ToyDr-W/PUYA_orgel_SW_SPI_BTL/Circuit_Schematic/orgel_SW_F002A_8_SPI_BTL.jpg

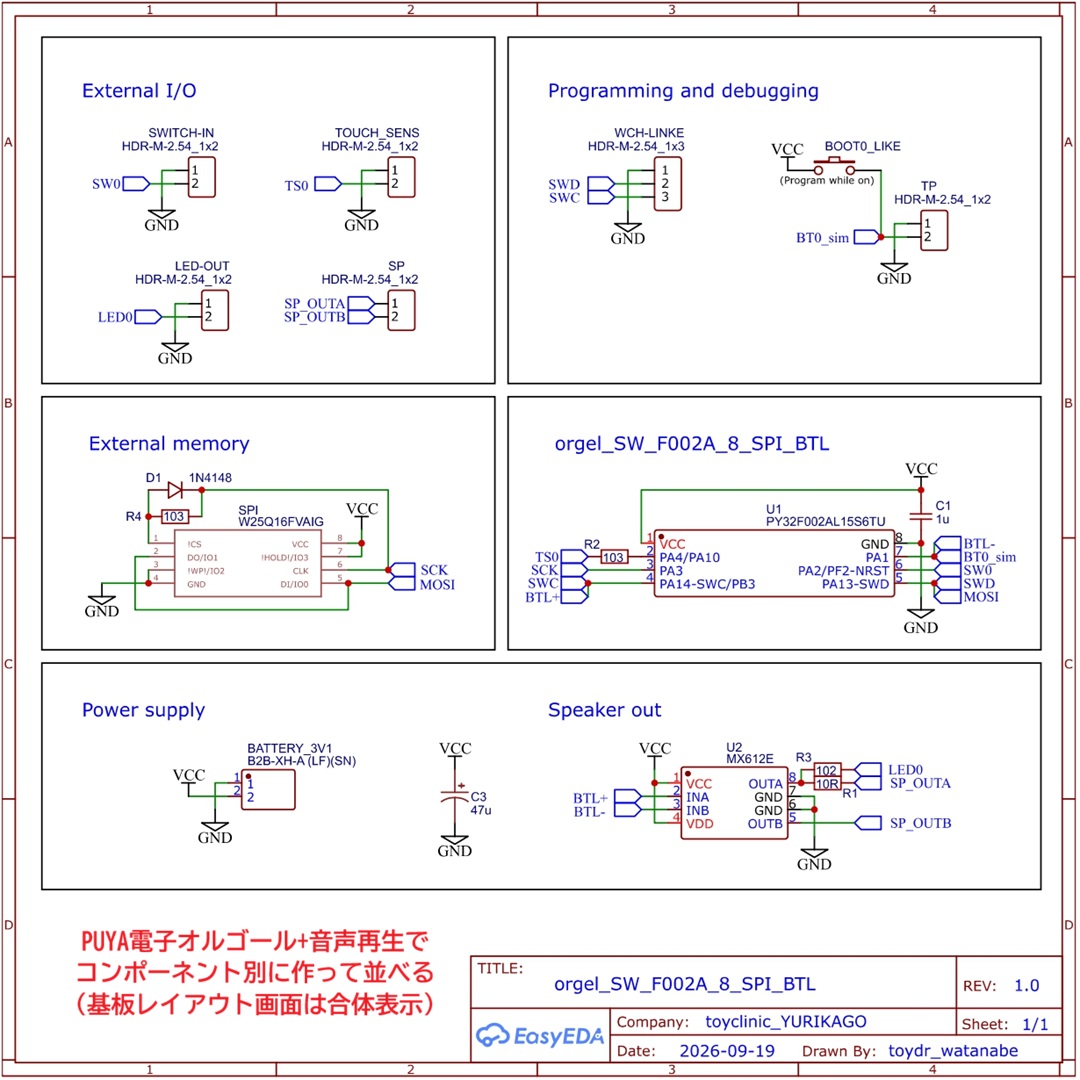
Circuit_Schematic/orgel_SW_F002A_8_SPI_BTL.jpg
