ToyDr-W/PUYA_orgel_SW_SPI_BTL/PCB_Layout/orgel_SW_F002A_8_SPI_BTL.png

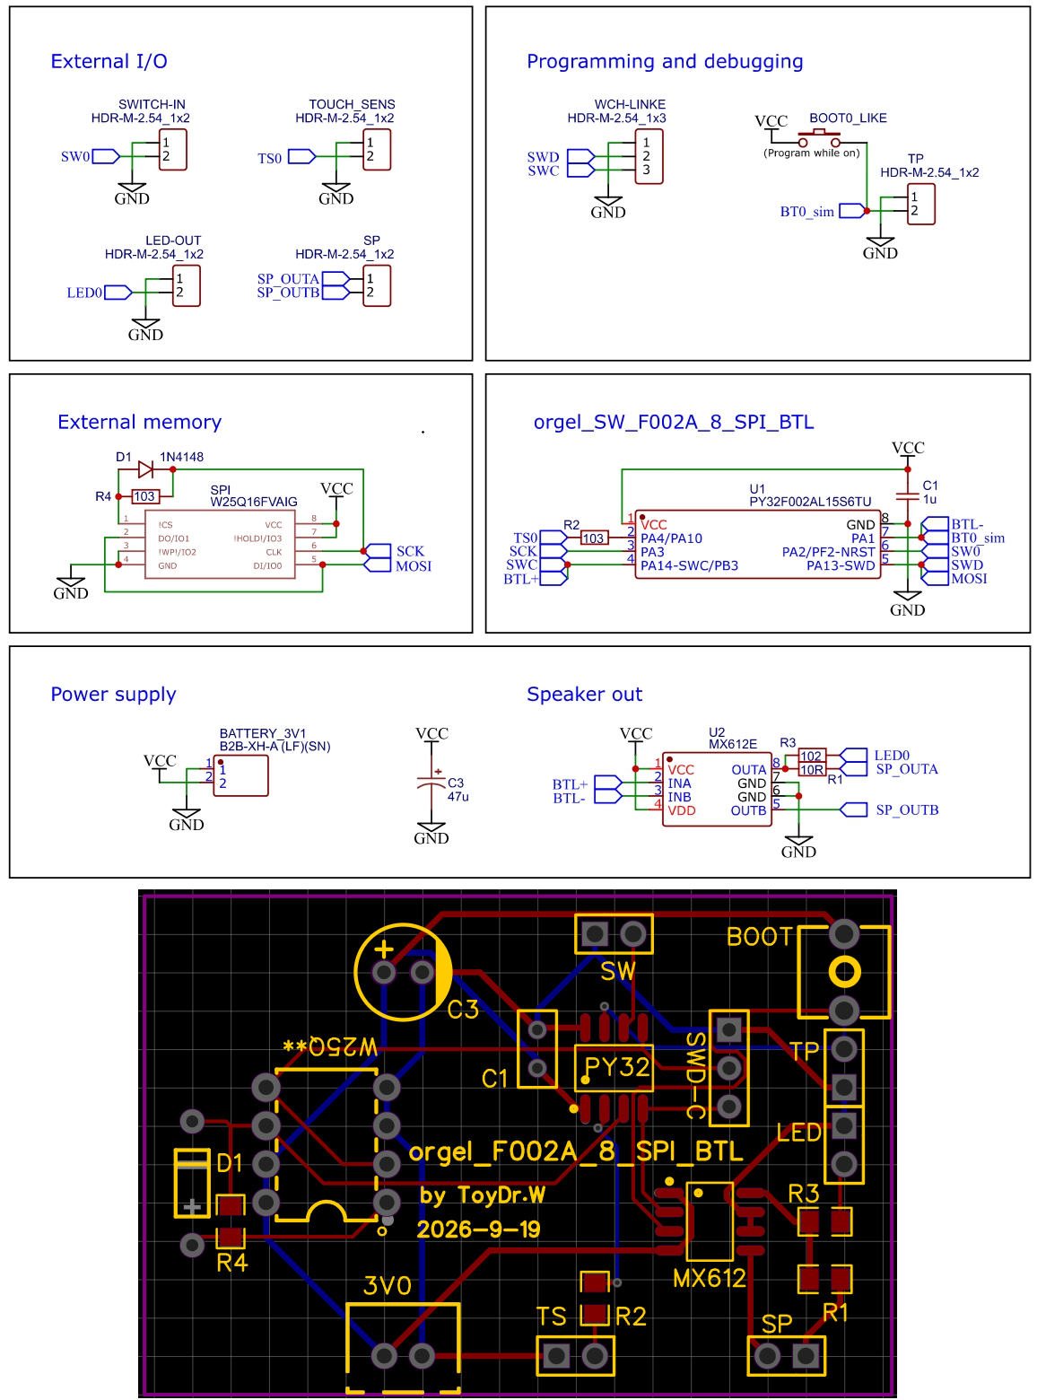
PCB_Layout/orgel_SW_F002A_8_SPI_BTL.png
