ToyDr-W/PUYA_orgel_SW_SPI_BTL/PCB_Layout/orgel_SW_F002A_SPI_BTL_Rev1 (2).png

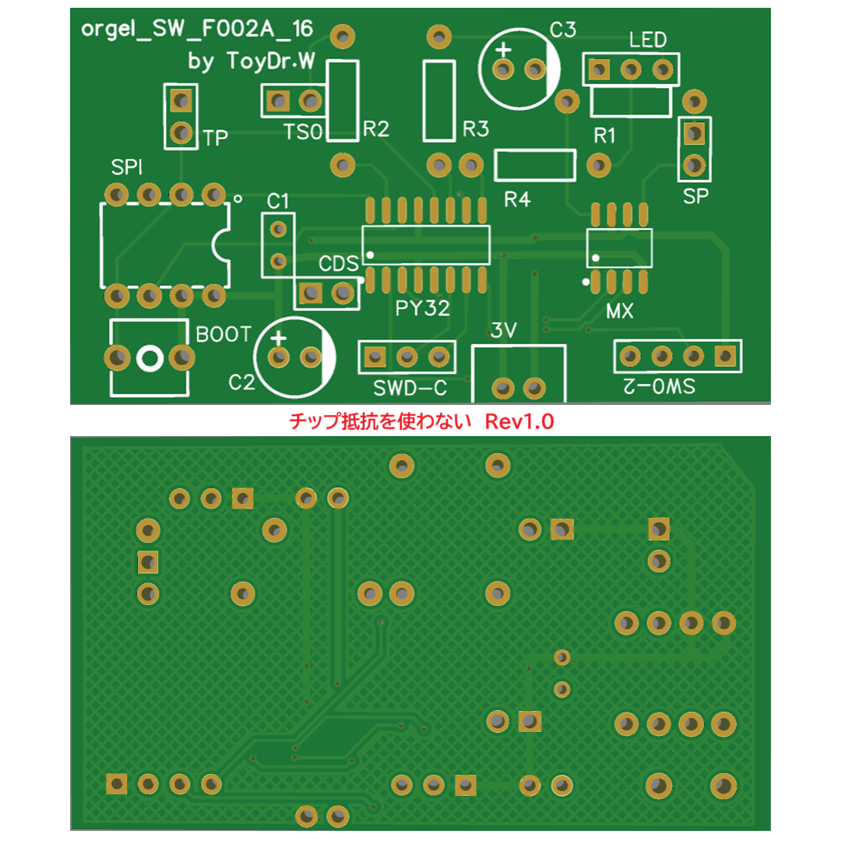
PCB_Layout/orgel_SW_F002A_SPI_BTL_Rev1 (2).png
