ToyDr-W/PUYA_orgel_SW_SPI_BTL/orgel1_4_260929/tool_voice/wav2txt/Release/BuildLog.htm

ビルド ログ

| | リビルド 開始: プロジェクト: wav2txt、構成: Release|Win32

コマンド ライン

一時ファイル "d:\ooizumi\PIC\orgel5_7\tool\wav2txt\Release\RSP00000158687376.rsp" を作成しています。内容 :
[
/O2 /Oi /GL /D "WIN32" /D "NDEBUG" /D "_CONSOLE" /D "_UNICODE" /D "UNICODE" /FD /EHsc /MD /Gy /Fo"Release\\" /Fd"Release\vc90.pdb" /W3 /c /Zi /TP .\wav2txt.cpp
]
コマンド ライン "cl.exe @d:\ooizumi\PIC\orgel5_7\tool\wav2txt\Release\RSP00000158687376.rsp /nologo /errorReport:prompt" を作成しています。
一時ファイル "d:\ooizumi\PIC\orgel5_7\tool\wav2txt\Release\RSP00000258687376.rsp" を作成しています。内容 :
[
/OUT:"D:\ooizumi\PIC\orgel5_7\tool\wav2txt\Release\wav2txt.exe" /INCREMENTAL:NO /MANIFEST /MANIFESTFILE:"Release\wav2txt.exe.intermediate.manifest" /MANIFESTUAC:"level='asInvoker' uiAccess='false'" /DEBUG /PDB:"D:\ooizumi\PIC\orgel5_7\tool\wav2txt\Release\wav2txt.pdb" /SUBSYSTEM:CONSOLE /OPT:REF /OPT:ICF /LTCG /DYNAMICBASE /NXCOMPAT /MACHINE:X86 kernel32.lib user32.lib gdi32.lib winspool.lib comdlg32.lib advapi32.lib shell32.lib ole32.lib oleaut32.lib uuid.lib odbc32.lib odbccp32.lib

".\Release\wav2txt.obj"
]
コマンド ライン "link.exe @d:\ooizumi\PIC\orgel5_7\tool\wav2txt\Release\RSP00000258687376.rsp /NOLOGO /ERRORREPORT:PROMPT" を作成しています。
一時ファイル "d:\ooizumi\PIC\orgel5_7\tool\wav2txt\Release\RSP00000358687376.rsp" を作成しています。内容 :
[
/outputresource:".\Release\wav2txt.exe;#1" /manifest

.\Release\wav2txt.exe.intermediate.manifest
]
コマンド ライン "mt.exe @d:\ooizumi\PIC\orgel5_7\tool\wav2txt\Release\RSP00000358687376.rsp /nologo" を作成しています。
一時ファイル "d:\ooizumi\PIC\orgel5_7\tool\wav2txt\Release\BAT00000458687376.bat" を作成しています。内容 :
[
@echo マニフェスト リソースの最終更新日時: %TIME% (%DATE%) > .\Release\mt.dep
]
コマンド ライン "d:\ooizumi\PIC\orgel5_7\tool\wav2txt\Release\BAT00000458687376.bat" を作成しています。

出力ウィンドウ

コンパイルしています...
wav2txt.cpp
.\wav2txt.cpp(223) : warning C4996: 'fopen': This function or variable may be unsafe. Consider using fopen_s instead. To disable deprecation, use _CRT_SECURE_NO_WARNINGS. See online help for details.
C:\Program Files (x86)\Microsoft Visual Studio 9.0\VC\include\stdio.h(237) : 'fopen' の宣言を確認してください。
.\wav2txt.cpp(228) : warning C4996: 'fileno': The POSIX name for this item is deprecated. Instead, use the ISO C++ conformant name: _fileno. See online help for details.
C:\Program Files (x86)\Microsoft Visual Studio 9.0\VC\include\stdio.h(722) : 'fileno' の宣言を確認してください。
.\wav2txt.cpp(240) : warning C4996: 'fopen': This function or variable may be unsafe. Consider using fopen_s instead. To disable deprecation, use _CRT_SECURE_NO_WARNINGS. See online help for details.
C:\Program Files (x86)\Microsoft Visual Studio 9.0\VC\include\stdio.h(237) : 'fopen' の宣言を確認してください。
リンクしています...
コード生成しています。
コード生成が終了しました。
マニフェストを埋め込んでいます...

結果

| | ビルドログは "file://d:\ooizumi\PIC\orgel5_7\tool\wav2txt\Release\BuildLog.htm" に保存されました。 wav2txt - エラー 0、警告 3
