ToyDr-W/PUYA_orgel_SW_SPI_BTL/orgel1_4_261018/tool_voice/txt2asm/Release/BuildLog.htm

ビルド ログ

| | リビルド 開始: プロジェクト: txt2asm、構成: Release|Win32

コマンド ライン

一時ファイル "c:\ooizumis\WCH\orgel1_4-NNN\tool_voice\txt2asm\Release\RSP00000527847000.rsp" を作成しています。内容 :
[
/O2 /Oi /GL /D "WIN32" /D "NDEBUG" /D "_CONSOLE" /D "_UNICODE" /D "UNICODE" /FD /EHsc /MD /Gy /Fo"Release\\" /Fd"Release\vc90.pdb" /W3 /c /Zi /TP ".\txt2asm.cpp"
]
コマンド ライン "cl.exe @"c:\ooizumis\WCH\orgel1_4-NNN\tool_voice\txt2asm\Release\RSP00000527847000.rsp" /nologo /errorReport:prompt" を作成しています。
一時ファイル "c:\ooizumis\WCH\orgel1_4-NNN\tool_voice\txt2asm\Release\RSP00000627847000.rsp" を作成しています。内容 :
[
/OUT:"C:\ooizumis\WCH\orgel1_4-NNN\tool_voice\txt2asm\Release\txt2asm.exe" /INCREMENTAL:NO /MANIFEST /MANIFESTFILE:"Release\txt2asm.exe.intermediate.manifest" /MANIFESTUAC:"level='asInvoker' uiAccess='false'" /DEBUG /PDB:"C:\ooizumis\WCH\orgel1_4-NNN\tool_voice\txt2asm\Release\txt2asm.pdb" /SUBSYSTEM:CONSOLE /OPT:REF /OPT:ICF /LTCG /DYNAMICBASE /NXCOMPAT /MACHINE:X86 kernel32.lib user32.lib gdi32.lib winspool.lib comdlg32.lib advapi32.lib shell32.lib ole32.lib oleaut32.lib uuid.lib odbc32.lib odbccp32.lib

".\Release\txt2asm.obj"
]
コマンド ライン "link.exe @"c:\ooizumis\WCH\orgel1_4-NNN\tool_voice\txt2asm\Release\RSP00000627847000.rsp" /NOLOGO /ERRORREPORT:PROMPT" を作成しています。
一時ファイル "c:\ooizumis\WCH\orgel1_4-NNN\tool_voice\txt2asm\Release\RSP00000727847000.rsp" を作成しています。内容 :
[
/outputresource:".\Release\txt2asm.exe;#1" /manifest

".\Release\txt2asm.exe.intermediate.manifest"
]
コマンド ライン "mt.exe @"c:\ooizumis\WCH\orgel1_4-NNN\tool_voice\txt2asm\Release\RSP00000727847000.rsp" /nologo" を作成しています。
一時ファイル "c:\ooizumis\WCH\orgel1_4-NNN\tool_voice\txt2asm\Release\BAT00000827847000.bat" を作成しています。内容 :
[
@echo マニフェスト リソースの最終更新日時: %TIME% (%DATE%) > ".\Release\mt.dep"
]
コマンド ライン """c:\ooizumis\WCH\orgel1_4-NNN\tool_voice\txt2asm\Release\BAT00000827847000.bat""" を作成しています。

出力ウィンドウ

コンパイルしています...
txt2asm.cpp
.\txt2asm.cpp(240) : warning C4996: 'fopen': This function or variable may be unsafe. Consider using fopen_s instead. To disable deprecation, use _CRT_SECURE_NO_WARNINGS. See online help for details.
C:\Program Files (x86)\Microsoft Visual Studio 9.0\VC\include\stdio.h(237) : 'fopen' の宣言を確認してください。
.\txt2asm.cpp(298) : warning C4244: '=' : 'unsigned long' から 'unsigned short' への変換です。データが失われる可能性があります。
.\txt2asm.cpp(426) : warning C4996: 'fopen': This function or variable may be unsafe. Consider using fopen_s instead. To disable deprecation, use _CRT_SECURE_NO_WARNINGS. See online help for details.
C:\Program Files (x86)\Microsoft Visual Studio 9.0\VC\include\stdio.h(237) : 'fopen' の宣言を確認してください。
リンクしています...
コード生成しています。
コード生成が終了しました。
マニフェストを埋め込んでいます...

結果

| | ビルドログは "file://c:\ooizumis\WCH\orgel1_4-NNN\tool_voice\txt2asm\Release\BuildLog.htm" に保存されました。 txt2asm - エラー 0、警告 3
