ToyDr-W/PUYA_orgel_SW_SPI_BTL/orgel1_4_261018/tool_voice/wav2hex/Release/BuildLog.htm

ビルド ログ

| | リビルド 開始: プロジェクト: wav2hex、構成: Release|Win32

コマンド ライン

一時ファイル "c:\ooizumis\WCH\orgel1_4-NNN\tool_voice\wav2hex\Release\RSP00001127449432.rsp" を作成しています。内容 :
[
/GL /D "WIN32" /D "NDEBUG" /D "_UNICODE" /D "UNICODE" /FD /EHa /MD /Fo"Release\\" /Fd"Release\vc90.pdb" /W3 /c /Zi /clr /TP ".\wav2hex.cpp"
]
コマンド ライン "cl.exe @"c:\ooizumis\WCH\orgel1_4-NNN\tool_voice\wav2hex\Release\RSP00001127449432.rsp" /nologo /errorReport:prompt" を作成しています。
一時ファイル "c:\ooizumis\WCH\orgel1_4-NNN\tool_voice\wav2hex\Release\RSP00001227449432.rsp" を作成しています。内容 :
[
/OUT:"C:\ooizumis\WCH\orgel1_4-NNN\tool_voice\wav2hex\Release\wav2hex.exe" /INCREMENTAL:NO /MANIFEST /MANIFESTFILE:"Release\wav2hex.exe.intermediate.manifest" /MANIFESTUAC:"level='asInvoker' uiAccess='false'" /DEBUG /PDB:"C:\ooizumis\WCH\orgel1_4-NNN\tool_voice\wav2hex\Release\wav2hex.pdb" /LTCG /DYNAMICBASE /FIXED:No /NXCOMPAT /MACHINE:X86 ".\Release\wav2hex.obj"
]
コマンド ライン "link.exe @"c:\ooizumis\WCH\orgel1_4-NNN\tool_voice\wav2hex\Release\RSP00001227449432.rsp" /NOLOGO /ERRORREPORT:PROMPT" を作成しています。
一時ファイル "c:\ooizumis\WCH\orgel1_4-NNN\tool_voice\wav2hex\Release\RSP00001327449432.rsp" を作成しています。内容 :
[
/outputresource:".\Release\wav2hex.exe;#1" /manifest

".\Release\wav2hex.exe.intermediate.manifest"
]
コマンド ライン "mt.exe @"c:\ooizumis\WCH\orgel1_4-NNN\tool_voice\wav2hex\Release\RSP00001327449432.rsp" /nologo" を作成しています。
一時ファイル "c:\ooizumis\WCH\orgel1_4-NNN\tool_voice\wav2hex\Release\BAT00001427449432.bat" を作成しています。内容 :
[
@echo マニフェスト リソースの最終更新日時: %TIME% (%DATE%) > ".\Release\mt.dep"
]
コマンド ライン """c:\ooizumis\WCH\orgel1_4-NNN\tool_voice\wav2hex\Release\BAT00001427449432.bat""" を作成しています。

出力ウィンドウ

コンパイルしています...
wav2hex.cpp
.\wav2hex.cpp(533) : warning C4244: '=' : 'unsigned short' から 'unsigned char' への変換です。データが失われる可能性があります。
.\wav2hex.cpp(534) : warning C4244: '=' : 'unsigned short' から 'unsigned char' への変換です。データが失われる可能性があります。
.\wav2hex.cpp(535) : warning C4244: '=' : 'unsigned short' から 'unsigned char' への変換です。データが失われる可能性があります。
.\wav2hex.cpp(687) : warning C4996: 'fopen': This function or variable may be unsafe. Consider using fopen_s instead. To disable deprecation, use _CRT_SECURE_NO_WARNINGS. See online help for details.
C:\Program Files (x86)\Microsoft Visual Studio 9.0\VC\include\stdio.h(237) : 'fopen' の宣言を確認してください。
.\wav2hex.cpp(693) : warning C4996: 'fopen': This function or variable may be unsafe. Consider using fopen_s instead. To disable deprecation, use _CRT_SECURE_NO_WARNINGS. See online help for details.
C:\Program Files (x86)\Microsoft Visual Studio 9.0\VC\include\stdio.h(237) : 'fopen' の宣言を確認してください。
.\wav2hex.cpp(699) : warning C4996: 'fopen': This function or variable may be unsafe. Consider using fopen_s instead. To disable deprecation, use _CRT_SECURE_NO_WARNINGS. See online help for details.
C:\Program Files (x86)\Microsoft Visual Studio 9.0\VC\include\stdio.h(237) : 'fopen' の宣言を確認してください。
.\wav2hex.cpp(736) : warning C4996: 'fopen': This function or variable may be unsafe. Consider using fopen_s instead. To disable deprecation, use _CRT_SECURE_NO_WARNINGS. See online help for details.
C:\Program Files (x86)\Microsoft Visual Studio 9.0\VC\include\stdio.h(237) : 'fopen' の宣言を確認してください。
リンクしています...
コード生成しています。
コード生成が終了しました。
マニフェストを埋め込んでいます...

結果

| | ビルドログは "file://c:\ooizumis\WCH\orgel1_4-NNN\tool_voice\wav2hex\Release\BuildLog.htm" に保存されました。 wav2hex - エラー 0、警告 7
