ToyDr-W/PUYA_orgel_SW_SPI_BTL/Circuit_Schematic/orgel_SW_F002A_16_SPI_BTL.pdf

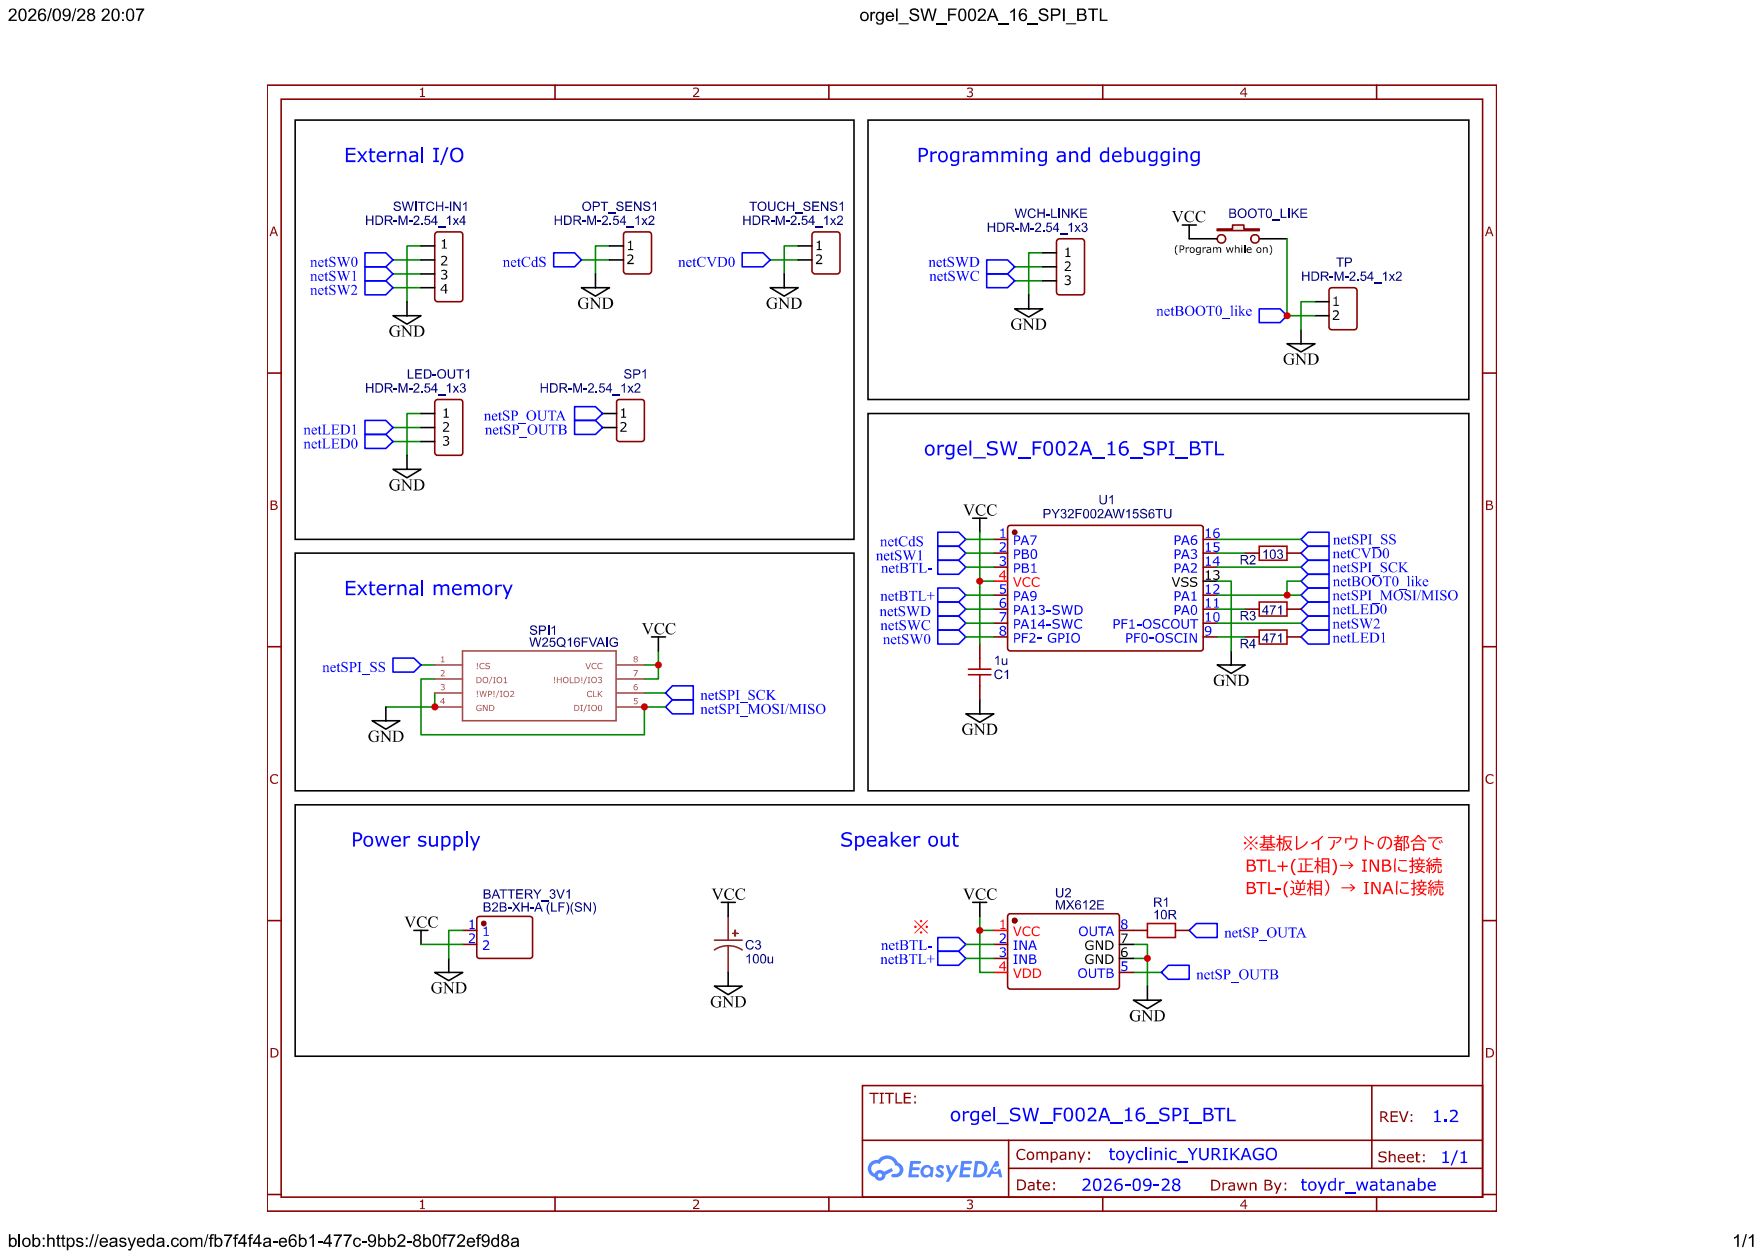
[picture p9: page 1]
