ToyDr-W/PUYA_orgel_SW_SPI_BTL/orgel1_4_260929/voice_AKA.c

static const unsigned char voice_AKA[]={
	125,
	133,
	143,
	139,
	113,
	107,
	122,
	145,
	135,
	119,
	117,
	136,
	137,
	128,
	126,
	137,
	133,
	119,
	118,
	128,
	136,
	131,
	127,
	126,
	125,
	126,
	128,
	130,
	129,
	126,
	128,
	130,
	130,
	130,
	128,
	125,
	118,
	119,
	130,
	137,
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
	};
