ToyDr-W/PUYA_orgel_SW_SPI_BTL/orgel1_4_260929/voice_AO.c

static const unsigned char voice_AO[]={
	127,
	127,
	127,
	127,
	127,
	127,
	127,
	127,
	127,
	127,
	127,
	127,
	127,
	127,
	127,
	127,
	127,
	127,
	127,
	128,
	128,
	128,
	127,
	127,
	127,
	126,
	126,
	125,
	140,
	141,
	126,
	102,
	112,
	126,
	140,
	124,
	127,
	126,
	136,
	125,
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
	};
