ToyDr-W/PUYA_orgel_SW_SPI_BTL/orgel1_4_260929/voice_BRAKE.c

static const unsigned char voice_BRAKE[]={
	136,
	134,
	138,
	138,
	133,
	133,
	138,
	137,
	132,
	134,
	141,
	133,
	132,
	139,
	139,
	133,
	134,
	141,
	136,
	131,
	135,
	141,
	130,
	134,
	140,
	137,
	129,
	138,
	142,
	133,
	130,
	140,
	139,
	129,
	138,
	139,
	135,
	128,
	141,
	140,
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
	};
