ToyDr-W/PUYA_orgel_SW_SPI_BTL/orgel1_4_260929/voice_KIIRO.c

static const unsigned char voice_KIIRO[]={
	127,
	127,
	127,
	127,
	127,
	127,
	127,
	127,
	127,
	127,
	127,
	127,
	127,
	127,
	127,
	127,
	127,
	127,
	127,
	127,
	127,
	127,
	127,
	127,
	127,
	127,
	127,
	127,
	127,
	127,
	127,
	127,
	127,
	127,
	127,
	127,
	127,
	127,
	127,
	127,
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
	};
