ToyDr-W/PUYA_orgel_SW_SPI_BTL/orgel1_4_260929/effect_KANE.asm

	align	2
	export	effect_KANE
effect_KANE
	dcw	effect_KANE_end-effect_KANE-3
	dcb	123
	dcb	106
	dcb	126
	dcb	143
	dcb	124
	dcb	124
	dcb	142
	dcb	126
	dcb	105
	dcb	128
	dcb	144
	dcb	124
	dcb	123
	dcb	140
	dcb	125
	dcb	110
	dcb	139
	dcb	141
	dcb	98
	dcb	123
	dcb	157
	dcb	120
	dcb	121
	dcb	164
	dcb	121
	dcb	57
	dcb	140
	dcb	183
	dcb	98
	dcb	123
	dcb	193
	dcb	99
	dcb	29
	dcb	171
	dcb	198
	dcb	71
	dcb	129
	dcb	209
	dcb	76
	dcb	22
	dcb	197
	dcb	202
	dcb	58
	dcb	132
	dcb	209
	dcb	61
	dcb	23
	dcb	219
	dcb	205
	dcb	46
	dcb	132
	dcb	205
	dcb	50
	dcb	31
	dcb	233
	dcb	204
	dcb	40
	dcb	126
	dcb	197
	dcb	50
	dcb	45
	dcb	240
	dcb	198
	dcb	35
	dcb	121
	dcb	191
	dcb	53
	dcb	56
	dcb	245
	dcb	193
	dcb	28
	dcb	115
	dcb	192
	dcb	56
	dcb	61
	dcb	254
	dcb	188
	dcb	10
	dcb	110
	dcb	202
	dcb	58
	dcb	67
	dcb	255
	dcb	177
	dcb	0
	dcb	112
	dcb	214
	dcb	59
	dcb	74
	dcb	255
	dcb	161
	dcb	0
	dcb	122
	dcb	224
	dcb	59
	dcb	83
	dcb	255
	dcb	145
	dcb	0
	dcb	135
	dcb	228
	dcb	61
	dcb	95
	dcb	255
	dcb	124
	dcb	0
	dcb	148
	dcb	231
	dcb	65
	dcb	102
	dcb	255
	dcb	106
	dcb	0
	dcb	161
	dcb	233
	dcb	67
	dcb	104
	dcb	249
	dcb	93
	dcb	0
	dcb	175
	dcb	240
	dcb	65
	dcb	99
	dcb	241
	dcb	83
	dcb	0
	dcb	193
	dcb	247
	dcb	57
	dcb	93
	dcb	234
	dcb	74
	dcb	0
	dcb	210
	dcb	248
	dcb	46
	dcb	87
	dcb	231
	dcb	69
	dcb	1
	dcb	225
	dcb	244
	dcb	32
	dcb	84
	dcb	228
	dcb	63
	dcb	13
	dcb	239
	dcb	236
	dcb	21
	dcb	83
	dcb	221
	dcb	62
	dcb	29
	dcb	249
	dcb	229
	dcb	12
	dcb	81
	dcb	219
	dcb	66
	dcb	43
	dcb	255
	dcb	222
	dcb	0
	dcb	78
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
	dcb	123
	dcb	134
	dcb	117
	dcb	117
	dcb	145
	dcb	141
	dcb	114
	dcb	122
	dcb	135
	dcb	118
	dcb	119
	dcb	146
	dcb	138
	dcb	112
	dcb	122
	dcb	135
	dcb	120
	dcb	121
	dcb	147
	dcb	136
	dcb	110
	dcb	122
	dcb	136
	dcb	121
	dcb	123
	dcb	147
	dcb	133
	dcb	108
	dcb	123
	dcb	138
effect_KANE_end

	end
