ToyDr-W/PUYA_orgel_SW_SPI_BTL/orgel1_4_260929/voice_ENGINE2.c

static const unsigned char voice_ENGINE2[]={
	78,
	60,
	62,
	83,
	57,
	84,
	89,
	71,
	86,
	105,
	98,
	119,
	141,
	121,
	131,
	130,
	113,
	124,
	143,
	103,
	90,
	136,
	111,
	115,
	148,
	125,
	123,
	109,
	94,
	124,
	106,
	89,
	65,
	67,
	76,
	42,
	45,
	57,
	78,
	70,
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
	};
