ToyDr-W/PUYA_orgel_SW_SPI_BTL/orgel1_4_260929/wave_RING33.asm

	export	wave_RING33
wave_RING33
	dcb	127
	dcb	129
	dcb	131
	dcb	134
	dcb	136
	dcb	140
	dcb	143
	dcb	147
	dcb	151
	dcb	155
	dcb	159
	dcb	163
	dcb	167
	dcb	172
	dcb	176
	dcb	180
	dcb	184
	dcb	188
	dcb	192
	dcb	195
	dcb	199
	dcb	202
	dcb	204
	dcb	207
	dcb	208
	dcb	210
	dcb	211
	dcb	212
	dcb	212
	dcb	211
	dcb	211
	dcb	209
	dcb	208
	dcb	206
	dcb	203
	dcb	200
	dcb	197
	dcb	194
	dcb	190
	dcb	186
	dcb	182
	dcb	178
	dcb	173
	dcb	169
	dcb	164
	dcb	160
	dcb	155
	dcb	151
	dcb	147
	dcb	143
	dcb	140
	dcb	137
	dcb	134
	dcb	132
	dcb	130
	dcb	128
	dcb	127
	dcb	127
	dcb	127
	dcb	127
	dcb	128
	dcb	129
	dcb	131
	dcb	134
	dcb	137
	dcb	140
	dcb	144
	dcb	148
	dcb	152
	dcb	157
	dcb	162
	dcb	168
	dcb	173
	dcb	178
	dcb	184
	dcb	190
	dcb	195
	dcb	200
	dcb	206
	dcb	211
	dcb	216
	dcb	220
	dcb	224
	dcb	228
	dcb	232
	dcb	235
	dcb	237
	dcb	239
	dcb	241
	dcb	242
	dcb	242
	dcb	242
	dcb	242
	dcb	241
	dcb	239
	dcb	237
	dcb	235
	dcb	232
	dcb	229
	dcb	225
	dcb	221
	dcb	217
	dcb	212
	dcb	208
	dcb	203
	dcb	198
	dcb	193
	dcb	188
	dcb	183
	dcb	178
	dcb	173
	dcb	168
	dcb	163
	dcb	159
	dcb	155
	dcb	151
	dcb	147
	dcb	144
	dcb	141
	dcb	138
	dcb	136
	dcb	134
	dcb	132
	dcb	130
	dcb	129
	dcb	128
	dcb	127
	dcb	127
	dcb	127
	dcb	127
	dcb	127
	dcb	127
	dcb	127
	dcb	127
	dcb	127
	dcb	127
	dcb	127
	dcb	127
	dcb	127
	dcb	126
	dcb	125
	dcb	124
	dcb	123
	dcb	121
	dcb	119
	dcb	117
	dcb	114
	dcb	111
	dcb	107
	dcb	104
	dcb	100
	dcb	95
	dcb	90
	dcb	86
	dcb	80
	dcb	75
	dcb	69
	dcb	64
	dcb	58
	dcb	52
	dcb	46
	dcb	40
	dcb	35
	dcb	29
	dcb	24
	dcb	19
	dcb	14
	dcb	9
	dcb	5
	dcb	1
	dcb	-2
	dcb	-5
	dcb	-8
	dcb	-9
	dcb	-11
	dcb	-11
	dcb	-12
	dcb	-11
	dcb	-10
	dcb	-9
	dcb	-7
	dcb	-4
	dcb	-1
	dcb	3
	dcb	7
	dcb	11
	dcb	16
	dcb	21
	dcb	27
	dcb	33
	dcb	39
	dcb	45
	dcb	51
	dcb	57
	dcb	63
	dcb	70
	dcb	76
	dcb	82
	dcb	87
	dcb	93
	dcb	98
	dcb	103
	dcb	107
	dcb	111
	dcb	115
	dcb	118
	dcb	121
	dcb	123
	dcb	125
	dcb	126
	dcb	127
	dcb	127
	dcb	127
	dcb	127
	dcb	126
	dcb	124
	dcb	123
	dcb	121
	dcb	118
	dcb	116
	dcb	113
	dcb	110
	dcb	107
	dcb	104
	dcb	100
	dcb	97
	dcb	94
	dcb	91
	dcb	88
	dcb	86
	dcb	83
	dcb	81
	dcb	79
	dcb	78
	dcb	77
	dcb	76
	dcb	75
	dcb	75
	dcb	76
	dcb	76
	dcb	77
	dcb	79
	dcb	81
	dcb	83
	dcb	85
	dcb	88
	dcb	91
	dcb	94
	dcb	98
	dcb	101
	dcb	105
	dcb	109
	dcb	113
	dcb	116
	dcb	120
	dcb	124
	end
