ToyDr-W/PUYA_orgel_SW_SPI_BTL/orgel1_4_260929/wave_RING4.asm

	export	wave_RING4
wave_RING4
	dcb	128
	dcb	129
	dcb	132
	dcb	134
	dcb	137
	dcb	140
	dcb	143
	dcb	147
	dcb	150
	dcb	154
	dcb	158
	dcb	162
	dcb	166
	dcb	169
	dcb	173
	dcb	177
	dcb	180
	dcb	183
	dcb	185
	dcb	188
	dcb	190
	dcb	191
	dcb	192
	dcb	192
	dcb	192
	dcb	192
	dcb	191
	dcb	189
	dcb	187
	dcb	185
	dcb	182
	dcb	179
	dcb	176
	dcb	172
	dcb	168
	dcb	164
	dcb	160
	dcb	156
	dcb	152
	dcb	148
	dcb	144
	dcb	141
	dcb	137
	dcb	135
	dcb	132
	dcb	130
	dcb	129
	dcb	128
	dcb	128
	dcb	128
	dcb	129
	dcb	130
	dcb	132
	dcb	135
	dcb	139
	dcb	143
	dcb	147
	dcb	152
	dcb	158
	dcb	163
	dcb	169
	dcb	176
	dcb	182
	dcb	189
	dcb	196
	dcb	203
	dcb	209
	dcb	215
	dcb	222
	dcb	227
	dcb	233
	dcb	238
	dcb	242
	dcb	246
	dcb	249
	dcb	251
	dcb	253
	dcb	255
	dcb	255
	dcb	255
	dcb	254
	dcb	252
	dcb	250
	dcb	247
	dcb	243
	dcb	239
	dcb	235
	dcb	230
	dcb	225
	dcb	219
	dcb	213
	dcb	207
	dcb	201
	dcb	194
	dcb	188
	dcb	182
	dcb	176
	dcb	170
	dcb	164
	dcb	159
	dcb	154
	dcb	150
	dcb	146
	dcb	142
	dcb	139
	dcb	136
	dcb	133
	dcb	131
	dcb	130
	dcb	129
	dcb	128
	dcb	128
	dcb	128
	dcb	128
	dcb	128
	dcb	128
	dcb	129
	dcb	130
	dcb	130
	dcb	131
	dcb	131
	dcb	132
	dcb	132
	dcb	132
	dcb	132
	dcb	131
	dcb	130
	dcb	129
	dcb	128
	dcb	127
	dcb	124
	dcb	122
	dcb	119
	dcb	116
	dcb	113
	dcb	109
	dcb	106
	dcb	102
	dcb	98
	dcb	94
	dcb	90
	dcb	87
	dcb	83
	dcb	79
	dcb	76
	dcb	73
	dcb	71
	dcb	68
	dcb	66
	dcb	65
	dcb	64
	dcb	64
	dcb	64
	dcb	64
	dcb	65
	dcb	67
	dcb	69
	dcb	71
	dcb	74
	dcb	77
	dcb	80
	dcb	84
	dcb	88
	dcb	92
	dcb	96
	dcb	100
	dcb	104
	dcb	108
	dcb	112
	dcb	115
	dcb	119
	dcb	121
	dcb	124
	dcb	126
	dcb	127
	dcb	128
	dcb	128
	dcb	128
	dcb	127
	dcb	126
	dcb	124
	dcb	121
	dcb	117
	dcb	113
	dcb	109
	dcb	104
	dcb	98
	dcb	93
	dcb	87
	dcb	80
	dcb	74
	dcb	67
	dcb	60
	dcb	53
	dcb	47
	dcb	41
	dcb	34
	dcb	29
	dcb	23
	dcb	18
	dcb	14
	dcb	10
	dcb	7
	dcb	5
	dcb	3
	dcb	1
	dcb	1
	dcb	1
	dcb	2
	dcb	4
	dcb	6
	dcb	9
	dcb	13
	dcb	17
	dcb	21
	dcb	26
	dcb	31
	dcb	37
	dcb	43
	dcb	49
	dcb	55
	dcb	62
	dcb	68
	dcb	74
	dcb	80
	dcb	86
	dcb	92
	dcb	97
	dcb	102
	dcb	106
	dcb	110
	dcb	114
	dcb	117
	dcb	120
	dcb	123
	dcb	125
	dcb	126
	dcb	127
	dcb	128
	dcb	128
	dcb	128
	dcb	128
	dcb	128
	dcb	128
	dcb	127
	dcb	126
	dcb	126
	dcb	125
	dcb	125
	dcb	124
	dcb	124
	dcb	124
	dcb	124
	dcb	125
	dcb	126
	dcb	127
	end
