ToyDr-W/PUYA_orgel_SW_SPI_BTL/orgel1_4_260929/wave_SAW.asm

	export	wave_SAW
wave_SAW
	dcb	128
	dcb	130
	dcb	132
	dcb	134
	dcb	136
	dcb	137
	dcb	139
	dcb	141
	dcb	142
	dcb	144
	dcb	145
	dcb	146
	dcb	147
	dcb	148
	dcb	149
	dcb	149
	dcb	150
	dcb	150
	dcb	150
	dcb	151
	dcb	151
	dcb	151
	dcb	151
	dcb	151
	dcb	151
	dcb	151
	dcb	151
	dcb	151
	dcb	151
	dcb	151
	dcb	151
	dcb	152
	dcb	152
	dcb	153
	dcb	154
	dcb	154
	dcb	156
	dcb	157
	dcb	158
	dcb	160
	dcb	161
	dcb	163
	dcb	165
	dcb	167
	dcb	169
	dcb	171
	dcb	173
	dcb	175
	dcb	177
	dcb	179
	dcb	182
	dcb	184
	dcb	185
	dcb	187
	dcb	189
	dcb	191
	dcb	192
	dcb	193
	dcb	194
	dcb	195
	dcb	196
	dcb	197
	dcb	197
	dcb	197
	dcb	197
	dcb	197
	dcb	197
	dcb	197
	dcb	196
	dcb	196
	dcb	195
	dcb	195
	dcb	194
	dcb	194
	dcb	193
	dcb	193
	dcb	193
	dcb	193
	dcb	193
	dcb	193
	dcb	194
	dcb	195
	dcb	196
	dcb	197
	dcb	198
	dcb	200
	dcb	202
	dcb	204
	dcb	207
	dcb	210
	dcb	212
	dcb	215
	dcb	219
	dcb	222
	dcb	225
	dcb	229
	dcb	232
	dcb	235
	dcb	239
	dcb	242
	dcb	245
	dcb	247
	dcb	249
	dcb	251
	dcb	253
	dcb	254
	dcb	255
	dcb	255
	dcb	254
	dcb	253
	dcb	251
	dcb	249
	dcb	246
	dcb	243
	dcb	239
	dcb	234
	dcb	228
	dcb	222
	dcb	216
	dcb	209
	dcb	201
	dcb	193
	dcb	185
	dcb	176
	dcb	167
	dcb	157
	dcb	148
	dcb	138
	dcb	128
	dcb	118
	dcb	108
	dcb	99
	dcb	89
	dcb	80
	dcb	71
	dcb	63
	dcb	55
	dcb	47
	dcb	40
	dcb	34
	dcb	28
	dcb	22
	dcb	17
	dcb	13
	dcb	10
	dcb	7
	dcb	5
	dcb	3
	dcb	2
	dcb	1
	dcb	1
	dcb	2
	dcb	3
	dcb	5
	dcb	7
	dcb	9
	dcb	11
	dcb	14
	dcb	17
	dcb	21
	dcb	24
	dcb	27
	dcb	31
	dcb	34
	dcb	37
	dcb	41
	dcb	44
	dcb	46
	dcb	49
	dcb	52
	dcb	54
	dcb	56
	dcb	58
	dcb	59
	dcb	60
	dcb	61
	dcb	62
	dcb	63
	dcb	63
	dcb	63
	dcb	63
	dcb	63
	dcb	63
	dcb	62
	dcb	62
	dcb	61
	dcb	61
	dcb	60
	dcb	60
	dcb	59
	dcb	59
	dcb	59
	dcb	59
	dcb	59
	dcb	59
	dcb	59
	dcb	60
	dcb	61
	dcb	62
	dcb	63
	dcb	64
	dcb	65
	dcb	67
	dcb	69
	dcb	71
	dcb	72
	dcb	74
	dcb	77
	dcb	79
	dcb	81
	dcb	83
	dcb	85
	dcb	87
	dcb	89
	dcb	91
	dcb	93
	dcb	95
	dcb	96
	dcb	98
	dcb	99
	dcb	100
	dcb	102
	dcb	102
	dcb	103
	dcb	104
	dcb	104
	dcb	105
	dcb	105
	dcb	105
	dcb	105
	dcb	105
	dcb	105
	dcb	105
	dcb	105
	dcb	105
	dcb	105
	dcb	105
	dcb	105
	dcb	106
	dcb	106
	dcb	106
	dcb	107
	dcb	107
	dcb	108
	dcb	109
	dcb	110
	dcb	111
	dcb	112
	dcb	114
	dcb	115
	dcb	117
	dcb	119
	dcb	120
	dcb	122
	dcb	124
	dcb	126
	end
