ToyDr-W/PUYA_orgel_SW_SPI_BTL/orgel1_4_260929/wave_SHEPARD.asm

	export	wave_SHEPARD
wave_SHEPARD
	dcb	128
	dcb	147
	dcb	165
	dcb	182
	dcb	199
	dcb	213
	dcb	226
	dcb	237
	dcb	245
	dcb	251
	dcb	254
	dcb	255
	dcb	255
	dcb	252
	dcb	247
	dcb	242
	dcb	235
	dcb	227
	dcb	220
	dcb	213
	dcb	206
	dcb	200
	dcb	195
	dcb	191
	dcb	189
	dcb	188
	dcb	189
	dcb	191
	dcb	194
	dcb	198
	dcb	204
	dcb	209
	dcb	215
	dcb	221
	dcb	226
	dcb	231
	dcb	234
	dcb	236
	dcb	237
	dcb	236
	dcb	233
	dcb	228
	dcb	222
	dcb	214
	dcb	205
	dcb	194
	dcb	183
	dcb	172
	dcb	160
	dcb	149
	dcb	139
	dcb	130
	dcb	122
	dcb	116
	dcb	112
	dcb	110
	dcb	110
	dcb	113
	dcb	118
	dcb	125
	dcb	133
	dcb	143
	dcb	155
	dcb	167
	dcb	179
	dcb	192
	dcb	204
	dcb	215
	dcb	225
	dcb	233
	dcb	239
	dcb	244
	dcb	246
	dcb	246
	dcb	243
	dcb	239
	dcb	232
	dcb	223
	dcb	213
	dcb	202
	dcb	190
	dcb	178
	dcb	165
	dcb	153
	dcb	142
	dcb	131
	dcb	122
	dcb	114
	dcb	108
	dcb	104
	dcb	101
	dcb	100
	dcb	101
	dcb	103
	dcb	105
	dcb	109
	dcb	113
	dcb	117
	dcb	121
	dcb	124
	dcb	127
	dcb	128
	dcb	128
	dcb	127
	dcb	124
	dcb	120
	dcb	114
	dcb	107
	dcb	99
	dcb	89
	dcb	80
	dcb	70
	dcb	60
	dcb	51
	dcb	43
	dcb	36
	dcb	31
	dcb	28
	dcb	27
	dcb	28
	dcb	31
	dcb	37
	dcb	45
	dcb	55
	dcb	67
	dcb	81
	dcb	96
	dcb	112
	dcb	128
	dcb	144
	dcb	160
	dcb	175
	dcb	189
	dcb	201
	dcb	211
	dcb	219
	dcb	225
	dcb	228
	dcb	229
	dcb	228
	dcb	225
	dcb	220
	dcb	213
	dcb	205
	dcb	196
	dcb	186
	dcb	176
	dcb	167
	dcb	157
	dcb	149
	dcb	142
	dcb	136
	dcb	132
	dcb	129
	dcb	128
	dcb	128
	dcb	129
	dcb	132
	dcb	135
	dcb	139
	dcb	143
	dcb	147
	dcb	151
	dcb	153
	dcb	155
	dcb	156
	dcb	155
	dcb	152
	dcb	148
	dcb	142
	dcb	134
	dcb	125
	dcb	114
	dcb	103
	dcb	91
	dcb	78
	dcb	66
	dcb	54
	dcb	43
	dcb	33
	dcb	24
	dcb	17
	dcb	13
	dcb	10
	dcb	10
	dcb	12
	dcb	17
	dcb	23
	dcb	31
	dcb	41
	dcb	52
	dcb	64
	dcb	77
	dcb	89
	dcb	101
	dcb	113
	dcb	123
	dcb	131
	dcb	138
	dcb	143
	dcb	146
	dcb	146
	dcb	144
	dcb	140
	dcb	134
	dcb	126
	dcb	117
	dcb	107
	dcb	96
	dcb	84
	dcb	73
	dcb	62
	dcb	51
	dcb	42
	dcb	34
	dcb	28
	dcb	23
	dcb	20
	dcb	19
	dcb	20
	dcb	22
	dcb	25
	dcb	30
	dcb	35
	dcb	41
	dcb	47
	dcb	52
	dcb	58
	dcb	62
	dcb	65
	dcb	67
	dcb	68
	dcb	67
	dcb	65
	dcb	61
	dcb	56
	dcb	50
	dcb	43
	dcb	36
	dcb	29
	dcb	21
	dcb	14
	dcb	9
	dcb	4
	dcb	1
	dcb	0
	dcb	2
	dcb	5
	dcb	11
	dcb	19
	dcb	30
	dcb	43
	dcb	57
	dcb	74
	dcb	91
	dcb	109
	end
