ToyDr-W/PUYA_orgel_SW_SPI_BTL/orgel1_4_260929/wave_SIN.asm

	export	wave_SIN
wave_SIN
	dcb	128
	dcb	125
	dcb	122
	dcb	119
	dcb	116
	dcb	112
	dcb	109
	dcb	106
	dcb	103
	dcb	100
	dcb	97
	dcb	94
	dcb	91
	dcb	88
	dcb	85
	dcb	82
	dcb	79
	dcb	76
	dcb	74
	dcb	71
	dcb	68
	dcb	65
	dcb	63
	dcb	60
	dcb	57
	dcb	55
	dcb	52
	dcb	50
	dcb	47
	dcb	45
	dcb	43
	dcb	40
	dcb	38
	dcb	36
	dcb	34
	dcb	32
	dcb	30
	dcb	28
	dcb	26
	dcb	24
	dcb	22
	dcb	20
	dcb	19
	dcb	17
	dcb	16
	dcb	14
	dcb	13
	dcb	12
	dcb	10
	dcb	9
	dcb	8
	dcb	7
	dcb	6
	dcb	5
	dcb	5
	dcb	4
	dcb	3
	dcb	3
	dcb	2
	dcb	2
	dcb	1
	dcb	1
	dcb	1
	dcb	1
	dcb	1
	dcb	1
	dcb	1
	dcb	1
	dcb	1
	dcb	2
	dcb	2
	dcb	3
	dcb	3
	dcb	4
	dcb	5
	dcb	5
	dcb	6
	dcb	7
	dcb	8
	dcb	9
	dcb	10
	dcb	12
	dcb	13
	dcb	14
	dcb	16
	dcb	17
	dcb	19
	dcb	20
	dcb	22
	dcb	24
	dcb	26
	dcb	28
	dcb	30
	dcb	32
	dcb	34
	dcb	36
	dcb	38
	dcb	40
	dcb	43
	dcb	45
	dcb	47
	dcb	50
	dcb	52
	dcb	55
	dcb	57
	dcb	60
	dcb	63
	dcb	65
	dcb	68
	dcb	71
	dcb	74
	dcb	76
	dcb	79
	dcb	82
	dcb	85
	dcb	88
	dcb	91
	dcb	94
	dcb	97
	dcb	100
	dcb	103
	dcb	106
	dcb	109
	dcb	112
	dcb	116
	dcb	119
	dcb	122
	dcb	125
	dcb	128
	dcb	131
	dcb	134
	dcb	137
	dcb	140
	dcb	144
	dcb	147
	dcb	150
	dcb	153
	dcb	156
	dcb	159
	dcb	162
	dcb	165
	dcb	168
	dcb	171
	dcb	174
	dcb	177
	dcb	180
	dcb	182
	dcb	185
	dcb	188
	dcb	191
	dcb	193
	dcb	196
	dcb	199
	dcb	201
	dcb	204
	dcb	206
	dcb	209
	dcb	211
	dcb	213
	dcb	216
	dcb	218
	dcb	220
	dcb	222
	dcb	224
	dcb	226
	dcb	228
	dcb	230
	dcb	232
	dcb	234
	dcb	236
	dcb	237
	dcb	239
	dcb	240
	dcb	242
	dcb	243
	dcb	244
	dcb	246
	dcb	247
	dcb	248
	dcb	249
	dcb	250
	dcb	251
	dcb	251
	dcb	252
	dcb	253
	dcb	253
	dcb	254
	dcb	254
	dcb	255
	dcb	255
	dcb	255
	dcb	255
	dcb	255
	dcb	255
	dcb	255
	dcb	255
	dcb	255
	dcb	254
	dcb	254
	dcb	253
	dcb	253
	dcb	252
	dcb	251
	dcb	251
	dcb	250
	dcb	249
	dcb	248
	dcb	247
	dcb	246
	dcb	244
	dcb	243
	dcb	242
	dcb	240
	dcb	239
	dcb	237
	dcb	236
	dcb	234
	dcb	232
	dcb	230
	dcb	228
	dcb	226
	dcb	224
	dcb	222
	dcb	220
	dcb	218
	dcb	216
	dcb	213
	dcb	211
	dcb	209
	dcb	206
	dcb	204
	dcb	201
	dcb	199
	dcb	196
	dcb	193
	dcb	191
	dcb	188
	dcb	185
	dcb	182
	dcb	180
	dcb	177
	dcb	174
	dcb	171
	dcb	168
	dcb	165
	dcb	162
	dcb	159
	dcb	156
	dcb	153
	dcb	150
	dcb	147
	dcb	144
	dcb	140
	dcb	137
	dcb	134
	dcb	131
	end
