ToyDr-W/PUYA_orgel_SW_SPI_BTL/orgel1_4_260929/wave_SQUARE.asm

	export	wave_SQUARE
wave_SQUARE
	dcb	128
	dcb	138
	dcb	148
	dcb	158
	dcb	167
	dcb	177
	dcb	186
	dcb	194
	dcb	202
	dcb	210
	dcb	217
	dcb	224
	dcb	230
	dcb	235
	dcb	240
	dcb	244
	dcb	247
	dcb	250
	dcb	252
	dcb	253
	dcb	254
	dcb	255
	dcb	255
	dcb	254
	dcb	253
	dcb	252
	dcb	250
	dcb	248
	dcb	246
	dcb	244
	dcb	242
	dcb	239
	dcb	237
	dcb	235
	dcb	232
	dcb	230
	dcb	228
	dcb	227
	dcb	225
	dcb	224
	dcb	223
	dcb	223
	dcb	222
	dcb	222
	dcb	222
	dcb	223
	dcb	224
	dcb	225
	dcb	226
	dcb	227
	dcb	229
	dcb	230
	dcb	232
	dcb	234
	dcb	235
	dcb	237
	dcb	239
	dcb	240
	dcb	242
	dcb	243
	dcb	244
	dcb	245
	dcb	245
	dcb	246
	dcb	246
	dcb	246
	dcb	245
	dcb	245
	dcb	244
	dcb	243
	dcb	242
	dcb	240
	dcb	239
	dcb	237
	dcb	235
	dcb	234
	dcb	232
	dcb	230
	dcb	229
	dcb	227
	dcb	226
	dcb	225
	dcb	224
	dcb	223
	dcb	222
	dcb	222
	dcb	222
	dcb	223
	dcb	223
	dcb	224
	dcb	225
	dcb	227
	dcb	228
	dcb	230
	dcb	232
	dcb	235
	dcb	237
	dcb	239
	dcb	242
	dcb	244
	dcb	246
	dcb	248
	dcb	250
	dcb	252
	dcb	253
	dcb	254
	dcb	255
	dcb	255
	dcb	254
	dcb	253
	dcb	252
	dcb	250
	dcb	247
	dcb	244
	dcb	240
	dcb	235
	dcb	230
	dcb	224
	dcb	217
	dcb	210
	dcb	202
	dcb	194
	dcb	186
	dcb	177
	dcb	167
	dcb	158
	dcb	148
	dcb	138
	dcb	128
	dcb	118
	dcb	108
	dcb	98
	dcb	89
	dcb	79
	dcb	70
	dcb	62
	dcb	54
	dcb	46
	dcb	39
	dcb	32
	dcb	26
	dcb	21
	dcb	16
	dcb	12
	dcb	9
	dcb	6
	dcb	4
	dcb	3
	dcb	2
	dcb	1
	dcb	1
	dcb	2
	dcb	3
	dcb	4
	dcb	6
	dcb	8
	dcb	10
	dcb	12
	dcb	14
	dcb	17
	dcb	19
	dcb	21
	dcb	24
	dcb	26
	dcb	28
	dcb	29
	dcb	31
	dcb	32
	dcb	33
	dcb	33
	dcb	34
	dcb	34
	dcb	34
	dcb	33
	dcb	32
	dcb	31
	dcb	30
	dcb	29
	dcb	27
	dcb	26
	dcb	24
	dcb	22
	dcb	21
	dcb	19
	dcb	17
	dcb	16
	dcb	14
	dcb	13
	dcb	12
	dcb	11
	dcb	11
	dcb	10
	dcb	10
	dcb	10
	dcb	11
	dcb	11
	dcb	12
	dcb	13
	dcb	14
	dcb	16
	dcb	17
	dcb	19
	dcb	21
	dcb	22
	dcb	24
	dcb	26
	dcb	27
	dcb	29
	dcb	30
	dcb	31
	dcb	32
	dcb	33
	dcb	34
	dcb	34
	dcb	34
	dcb	33
	dcb	33
	dcb	32
	dcb	31
	dcb	29
	dcb	28
	dcb	26
	dcb	24
	dcb	21
	dcb	19
	dcb	17
	dcb	14
	dcb	12
	dcb	10
	dcb	8
	dcb	6
	dcb	4
	dcb	3
	dcb	2
	dcb	1
	dcb	1
	dcb	2
	dcb	3
	dcb	4
	dcb	6
	dcb	9
	dcb	12
	dcb	16
	dcb	21
	dcb	26
	dcb	32
	dcb	39
	dcb	46
	dcb	54
	dcb	62
	dcb	70
	dcb	79
	dcb	89
	dcb	98
	dcb	108
	dcb	118
	end
