ToyDr-W/PUYA_orgel_SW_SPI_BTL/orgel1_4_260929/enve_TREMOLO.asm

	export	enve_TREMOLO
enve_TREMOLO
	dcb	enve_TREMOLO_end-enve_TREMOLO-2
	dcb	255
	dcb	246
	dcb	178
	dcb	115
	dcb	222
	dcb	214
	dcb	155
	dcb	100
	dcb	193
	dcb	187
	dcb	135
	dcb	87
	dcb	168
	dcb	163
	dcb	118
	dcb	76
	dcb	147
	dcb	142
	dcb	103
	dcb	66
	dcb	128
	dcb	123
	dcb	89
	dcb	58
	dcb	111
	dcb	107
	dcb	78
	dcb	50
	dcb	97
	dcb	94
	dcb	68
	dcb	44
	dcb	84
	dcb	81
	dcb	59
	dcb	38
	dcb	73
	dcb	71
	dcb	51
	dcb	33
	dcb	64
	dcb	62
	dcb	45
	dcb	29
	dcb	56
	dcb	54
	dcb	39
	dcb	25
	dcb	48
	dcb	47
	dcb	34
	dcb	22
	dcb	42
	dcb	41
	dcb	30
	dcb	19
	dcb	37
	dcb	36
	dcb	26
	dcb	17
	dcb	32
	dcb	31
	dcb	22
	dcb	14
enve_TREMOLO_end
	end
