ToyDr-W/PUYA_orgel_SW_SPI_BTL/orgel1_4_261018/enve_EXP.asm

	export	enve_EXP
enve_EXP
	dcb	enve_EXP_end-enve_EXP-2
	dcb	255
	dcb	237
	dcb	221
	dcb	205
	dcb	191
	dcb	177
	dcb	165
	dcb	153
	dcb	143
	dcb	133
	dcb	123
	dcb	115
	dcb	107
	dcb	99
	dcb	92
	dcb	86
	dcb	80
	dcb	74
	dcb	69
	dcb	64
	dcb	60
	dcb	56
	dcb	52
	dcb	48
	dcb	45
	dcb	42
	dcb	39
	dcb	36
	dcb	33
	dcb	31
	dcb	29
	dcb	27
	dcb	25
	dcb	23
	dcb	22
	dcb	20
	dcb	19
	dcb	17
	dcb	16
	dcb	15
	dcb	14
	dcb	13
	dcb	12
	dcb	11
	dcb	10
	dcb	10
	dcb	9
	dcb	8
	dcb	8
	dcb	7
	dcb	7
	dcb	6
	dcb	6
	dcb	5
	dcb	5
	dcb	5
	dcb	4
	dcb	4
	dcb	4
	dcb	4
	dcb	3
	dcb	3
	dcb	3
	dcb	3
enve_EXP_end
	end
