ToyDr-W/PUYA_orgel_SW_SPI_BTL/orgel1_4_261018/enve_RSN.asm

	export	enve_RSN
enve_RSN
	dcb	enve_RSN_end-enve_RSN-2
	dcb	255
	dcb	230
	dcb	207
	dcb	190
	dcb	175
	dcb	163
	dcb	153
	dcb	145
	dcb	138
	dcb	131
	dcb	124
	dcb	118
	dcb	112
	dcb	107
	dcb	101
	dcb	96
	dcb	92
	dcb	87
	dcb	83
	dcb	78
	dcb	75
	dcb	71
	dcb	67
	dcb	64
	dcb	61
	dcb	58
	dcb	55
	dcb	52
	dcb	49
	dcb	47
	dcb	45
	dcb	42
	dcb	40
	dcb	38
	dcb	36
	dcb	35
	dcb	33
	dcb	31
	dcb	30
	dcb	28
	dcb	27
	dcb	25
	dcb	24
	dcb	23
	dcb	22
	dcb	21
	dcb	20
	dcb	19
	dcb	18
	dcb	17
	dcb	16
	dcb	15
	dcb	14
	dcb	14
	dcb	13
	dcb	12
	dcb	12
	dcb	11
	dcb	11
	dcb	10
	dcb	10
	dcb	9
	dcb	9
	dcb	8
enve_RSN_end
	end
