ToyDr-W/PUYA_orgel_SW_SPI_BTL/orgel1_4_261018/enve_VIB.asm

	export	enve_VIB
enve_VIB
	dcb	enve_VIB_end-enve_VIB-2
	dcb	255
	dcb	245
	dcb	235
	dcb	226
	dcb	217
	dcb	208
	dcb	200
	dcb	192
	dcb	182
	dcb	167
	dcb	152
	dcb	144
	dcb	143
	dcb	148
	dcb	151
	dcb	150
	dcb	141
	dcb	123
	dcb	105
	dcb	97
	dcb	101
	dcb	113
	dcb	125
	dcb	128
	dcb	121
	dcb	106
	dcb	92
	dcb	86
	dcb	90
	dcb	102
	dcb	114
	dcb	118
	dcb	112
	dcb	98
	dcb	85
	dcb	79
	dcb	83
	dcb	94
	dcb	105
	dcb	109
	dcb	103
	dcb	91
	dcb	79
	dcb	73
	dcb	77
	dcb	87
	dcb	97
	dcb	100
	dcb	95
	dcb	84
	dcb	72
	dcb	68
	dcb	71
	dcb	80
	dcb	89
	dcb	93
	dcb	88
	dcb	77
	dcb	67
	dcb	62
	dcb	66
	dcb	74
	dcb	83
	dcb	85
	dcb	81
	dcb	71
	dcb	62
	dcb	57
	dcb	60
	dcb	68
	dcb	76
	dcb	79
	dcb	75
	dcb	66
	dcb	57
	dcb	53
	dcb	56
	dcb	63
	dcb	70
	dcb	73
	dcb	69
	dcb	61
	dcb	53
	dcb	49
	dcb	51
	dcb	58
	dcb	65
	dcb	67
	dcb	64
	dcb	56
	dcb	48
	dcb	45
	dcb	48
	dcb	54
	dcb	60
	dcb	62
	dcb	59
	dcb	52
	dcb	45
	dcb	42
	dcb	44
	dcb	50
	dcb	55
	dcb	57
	dcb	54
	dcb	48
	dcb	41
	dcb	38
	dcb	40
	dcb	46
	dcb	51
	dcb	53
	dcb	50
	dcb	44
	dcb	38
	dcb	35
	dcb	37
	dcb	42
	dcb	47
	dcb	49
	dcb	46
	dcb	41
	dcb	35
	dcb	33
	dcb	34
	dcb	39
	dcb	43
	dcb	45
	dcb	43
	dcb	37
	dcb	32
	dcb	30
	dcb	32
	dcb	36
	dcb	40
	dcb	41
	dcb	39
	dcb	35
	dcb	30
	dcb	28
	dcb	29
	dcb	33
	dcb	37
	dcb	38
	dcb	36
	dcb	32
	dcb	28
	dcb	26
	dcb	27
	dcb	31
	dcb	34
	dcb	35
	dcb	33
	dcb	29
	dcb	25
	dcb	24
	dcb	25
	dcb	28
	dcb	31
	dcb	33
	dcb	31
	dcb	27
	dcb	24
	dcb	22
	dcb	23
	dcb	26
	dcb	29
	dcb	30
	dcb	28
	dcb	25
	dcb	22
	dcb	20
	dcb	21
	dcb	24
	dcb	27
	dcb	28
	dcb	26
	dcb	23
	dcb	20
	dcb	19
	dcb	20
	dcb	22
	dcb	25
	dcb	26
	dcb	24
	dcb	21
	dcb	18
	dcb	17
	dcb	18
	dcb	20
	dcb	23
	dcb	24
	dcb	22
	dcb	20
	dcb	17
	dcb	16
	dcb	17
	dcb	19
	dcb	21
	dcb	22
	dcb	21
	dcb	18
	dcb	16
	dcb	15
	dcb	15
	dcb	17
	dcb	19
	dcb	20
	dcb	19
	dcb	17
	dcb	15
	dcb	14
	dcb	14
	dcb	16
	dcb	18
	dcb	19
	dcb	18
	dcb	15
	dcb	13
	dcb	12
	dcb	13
	dcb	15
	dcb	17
	dcb	17
	dcb	16
	dcb	14
	dcb	12
	dcb	12
	dcb	12
	dcb	14
	dcb	15
	dcb	16
	dcb	15
	dcb	13
	dcb	11
	dcb	11
	dcb	11
	dcb	13
	dcb	14
	dcb	15
	dcb	14
	dcb	12
	dcb	11
	dcb	10
	dcb	10
	dcb	12
	dcb	13
	dcb	13
	dcb	13
	dcb	11
	dcb	10
	dcb	9
	dcb	10
	dcb	11
	dcb	12
	dcb	12
enve_VIB_end
	end
