ToyDr-W/PUYA_orgel_SW_SPI_BTL/(commit log)

2026-10-26 Update README with repair report request for doctors
    Added a section for repair reports and case submissions for doctors.
2026-10-27 Fix download link for 16-pin PY32F002.hex
    Updated download link for 16-pin binary to include raw=true.
2026-10-27 Restore repair report section for doctors in README
    Reintroduced the repair report and case submission section for doctors, including a link to the submission form.
2026-10-27 Restore binary file acquisition instructions in README
    Reintroduced the section on obtaining the binary (.hex) files with detailed instructions and links for 8-pin and 16-pin versions.
